aQuatonomous/Aqua-BMS-Monitor/bom.csv.xlsx

Designator | Footprint | Quantity | Value | LCSC Part # | Digikey Part # | Place | Logan Flag | Comments | Validated by Logan
3TFUSE1 | FUSE-SMD_3P-L9.5-W5.0_SFK-5030X | 1 | SCF9550-45-07 | C3667292 |  | Yes |  | Somehow | x
BC1 | 1nF_C0805 | 1 | 1nF | C94121 |  | Yes |  |  | x
BC2, C4 | 100pF_C0603 | 2 | 100pF | C160903 |  | Yes |  |  | x
BC3 | 603 | 1 | 0.47uF | C513577 |  | Yes |  |  | x
BD1, BD2, CHD1, D15, DD2, RD1, RD2 | 100V_Schottky | 7 | 100V | C698821 |  | Yes |  | Polarity -> should make sure assigned properly | x
BETTER1 | 1101A2CQEA-Switch | 1 | ~ |  | 2449-1101A2CQEA-ND | Yes | x | Throughhole - we can just order
BMSC1, C1-0, C2-0, CC2-1, CC3-2, CC4-3 | 402 | 6 | 220nF | C5159775 |  | Yes |  |  | x
BOOT0, RESET | SW_Push_YZA-009 | 2 | SW_Push | C49108621 |  | Yes |  |  | x
BQ296115DSGR1 | BQ296115DSGR | 1 | ~ | C2864839 |  | Yes |  |  | x
BR1 | 603 | 1 | 100 | C177347 |  | Yes | x | wrong value originally | Switched
C70, C71, C72, MCUC18 | 1uF_C0402 | 4 | 1 uF | C29266 |  | Yes |  | 16V, but that's okay! | x
CELLIN1 | CONN-TH_B5B-XH-A-LF-SN | 1 | 1 low 5 high | C157991 |  | DNP | x | This doesn't need to be PCBA - ungodly cheap tho
CHC1, CHC2, DC1, DC2, FC1, PCC1, PCC2, PDC1, PDC2, XC2, XCSHUN1 | 603 | 11 | 0.1uF | C14663 |  | Yes |  |  | x
CHD2, D17, DD1, DD3 | 16V_Zener | 4 | 16V | C2105 |  | Yes |  | Polarity -> should make sure assigned properly | x
CHFET1, DFET1, DFET2, DFET3, DFET4, FFET1, NMOS1 | NMOS | 7 | NMOS | C49435644 |  | Yes |  |  | x
CHR1, DR1, DR4, PCR2, R46, RR2 | 603 | 6 | 10M | C141675 |  | Yes |  |  | x
CHR2, DR3, FUSER2, PCR3, PDR3, USBR1, USBR2, XOUT1 | 5.1k_100mW_R0603 | 8 | 5.1k | C23186 |  | Yes |  |  | x
CR1, CR2, CR3, CR4, CR5 | 50_100mW_R0805 | 5 | 50 | C5355206 |  | Yes |  |  | x
D1 | D_SMF | 1 | SMF7V0A | C320558 |  | Yes | x | Found a new tvs diode - supposeely compatable with the DO-219AB package
D2 | D_SMF | 1 | SMF30A | C1973936 |  | Yes | x | Found a new tvs diode
DC3 | 47nF_C0603 | 1 | 47nF | C107093 |  | Yes |  |  | x
DCHGTP | TestPoint_Pad_D1.5mm | 1 | DCHGTP |  |  | Yes
DFETGATE3, DFETGATE4 | 603 | 2 | 10 | C109318 |  | Yes |  |  | x
DR2, PDR1 | 603 | 2 | 1k | C116692 |  | Yes |  |  | x
DR5 | 5.1k_R1210 | 1 | 1k | C185762 |  | Yes |  |  | x
DRGATE1, DRGATE2 | 51_R1206 | 2 | 51 | C702864 |  | Yes |  |  | x
FB1, FB2 | 2.2k_Ferrite_Bead_L0603 | 2 | 2.2k | C2942905 |  | Yes |  |  | x
FR1 | 603 | 1 | 20k | C22173 |  | Yes |  |  | x
FRSHUNT1 | 1m_Shunt_4W | 1 | 0.001 | C469381 |  | Yes |  |  | x
J1+A31:J31 | 3P_Pin_Header | 1 | UART Jpins | C2320 |  | DNP | x | This doesn't need to be PCBA - ungodly cheap tho
J2, J3, J4, J6 | AMASS_XT60PW-M | 4 | XT60PW-M | C98732 |  | Yes |  | great deal - keep pcba | x
J5 | HARWIN_M20-8890445 | 1 | SWD_01x04_Pin | C3324250 |  | DNP |  | This doesn't need to be pcba and is smt we should buy anyway
J7 | USB_C_DB-108PWB | 1 | USB_C_Female_USB2_Small | C5178541 |  | Yes |  | Alisa, please double check this just cause it's complex. But looks fine | x
LDR1, R47 | 603 | 2 | 10k | C98220 |  | Yes |  |  | x
LED1, LED2, LED3, LED5 | LED0805-RD | 4 | XZCM2CRK53WA-8VF | C7280946 |  | Yes |  |  | x
LEDR1, LEDR2, LEDR3, LEDR5 | 4k_R0805 | 4 | 4k | C2828855 |  | Yes |  |  | x
MCUC11, MCUC12, MCUC13, MCUC14, MCUC15, MCUC17 | 100nF_C0402 | 6 | 100 nF | C77020 |  | Yes |  |  | x
MCUC16 | 4.7uF_C0402 | 1 | 4.7 uF | C23733 |  | Yes |  |  | x
MCUC19 | 100nF_C0402 | 1 | 0.1 uF | C77020 |  | Yes |  |  | x
MCUC20, MCUC21 | 2.2uF_C0402 | 2 | 2.2 uF | C72203 |  | Yes |  |  | x
MCUDFETOFFTP | TestPoint_Pad_D1.5mm | 1 | MDfetOffTP |  |  | Yes
MCUR1, MCUR3, TSR1 | 10k_62.5mW_R0402 | 3 | 10k | C60490 |  | Yes |  |  | x
MCUR2, MCUR4 | 100k_R0402 | 2 | 100k | C60491 |  | Yes |  |  | x
MCUR5, MCUR6 | 4.7k_R0402 | 2 | 4.7k | C25940 |  | Yes |  |  | x
MCUTVS1, MCUTVS2, MCUTVS3, MCUTVS4 | 5V_TVS_SOD-323_L1.8-W1.3-LS2.5-BI | 4 | PTVSUC3D5VB | C918847 |  | Yes |  |  | x
OSCC1, OSCC2 | 16pF_C0402 | 2 | 16 pF | C77590 |  | Yes |  |  | x
PACKR1 | 10k_R1206 | 1 | 10k | C1489 |  | Yes |  |  | x
PCFET1, PDFET1 | PMOS | 2 | PMOS | C10884 |  | Yes |  | not 100% sure, but pre sure this is right | x
PCR1, XRC1, XRC2, XRC3, XRC4 | 1k_R1206 | 5 | 1k | C1469 |  | Yes |  |  | x
PDR2 | 603 | 1 | 10M | C141675 |  | Yes |  |  | x
Q6 | NPN_BJT | 1 | NPN | C53064208 |  | Yes |  | This is fine, but supposedly the same footprint as the pmos, but they look different | x
RC1, RC3, RC4 | 1uF_C0402 | 3 | 1uF | C29266 |  | Yes |  |  | x
RC2 | 402 | 1 | 22nF | C107026 |  | Yes |  |  | x
RR1 | 300_250mW_R1206 | 1 | 300 | C17887 |  | Yes |  |  | x
RSHUNT1, RSHUNT2, RSHUNT3, RSHUNT4 | 200_R1210 | 4 | 200 | C102427 |  | Yes |  | was - C26060 which is wrong | x
S1 | MHPS2285N | 1 | MHPS2285N |  | MHPS2285N-ND | DNP |  | Throughpin all good to ignore from JLC
S2, S3, S4, S5, S6 | SW_EG1218 | 5 | EG1218 |  | EG1903-ND | DNP |  | Not an amazing deal could do non-JLC
SC1, SC2, XC5 | 402 | 3 | 0.1 uF | C77020 |  | Yes |  |  | x
SC3 | 402 | 1 | 100 nF | C77020 |  | Yes |  | Blank - Added by logan | x
SCLTP | TestPoint_Pad_D1.5mm | 1 | MCUSCLTP |  |  | Yes
SDATP | TestPoint_Pad_D1.5mm | 1 | MCUSDATP |  |  | Yes
SRINN1, SRINP1, XRC5, XSHUN1 | 402 | 4 | 100 | C4350330 |  | Yes |  | Blank -Added by logan | x
TH1, TH3 | PTC_Thermistor_TMP6131LPGM | 2 | Thermistor_US |  |  | DNP |  | Through pin and we don't necessairly want them right in the board - I would not have them assembled on board
TH2 | PTC_Thermistor_TMP6131LPGM | 1 | Simitac 103-AT |  |  | DNP |  | Through pin and we don't necessairly want them right in the board - I would not have them assembled on board
TP1 | TestPoint_Pad_D1.5mm | 1 | BATplusTP
TP10 | TestPoint_Pad_D1.0mm | 1 | BatTP
TP11 | TestPoint_Pad_D1.0mm | 1 | CPTP
TP13 | TestPoint_Pad_D1.0mm | 1 | ReRHTP
TP14 | TestPoint_Pad_D1.0mm | 1 | ReColTP
TP16 | TestPoint_Pad_D1.0mm | 1 | Ccell0TP
TP17 | TestPoint_Pad_D1.5mm | 1 | TS2TP
TP18 | TestPoint_Pad_D1.0mm | 1 | HDQTP
TP20 | TestPoint_Pad_D1.5mm | 1 | CpackTP
TP21 | TestPoint_Pad_D1.5mm | 1 | DpackTP
TP22 | TestPoint_Pad_D1.0mm | 1 | ChGpackTP
TP23 | TestPoint_Pad_D1.5mm | 1 | RXTP
TP26 | TestPoint_Pad_D1.5mm | 1 | CDTP
TP27 | TestPoint_Pad_D1.0mm | 1 | FuseGate
TP28 | TestPoint_Pad_D1.5mm | 1 | Cell0TP
TP29 | TestPoint_Pad_D1.5mm | 1 | Cell1TP
TP30 | TestPoint_Pad_D1.5mm | 1 | Cell2TP
TP31 | TestPoint_Pad_D1.5mm | 1 | Cell3TP
TP32 | TestPoint_Pad_D1.5mm | 1 | Cell4TP
TP33 | TestPoint_Pad_D1.0mm | 1 | Ccell1TP
TP34 | TestPoint_Pad_D1.0mm | 1 | Ccell2TP
TP35 | TestPoint_Pad_D1.0mm | 1 | Ccell3TP
TP36 | TestPoint_Pad_D1.0mm | 1 | Ccell4TP
TP37 | TestPoint_Pad_D1.0mm | 1 | Xpro0VDDTP
TP38 | TestPoint_Pad_D1.0mm | 1 | Xcel4TP
TP39 | TestPoint_Pad_D1.0mm | 1 | Xcel3TP
TP40 | TestPoint_Pad_D1.0mm | 1 | Xcel1TP
TP41 | TestPoint_Pad_D1.0mm | 1 | Xcel2TP
TP42 | TestPoint_Pad_D1.5mm | 1 | XregTP
TP43 | TestPoint_Pad_D1.0mm | 1 | XoutTP
TP44 | TestPoint_Pad_D1.0mm | 1 | BregTP
TP46 | TestPoint_Pad_D1.0mm | 1 | Reg1TP
TP48 | TestPoint_Pad_D1.0mm | 1 | PCHGTP
TP49 | TestPoint_Pad_D1.0mm | 1 | PDSGTP
TP5 | TestPoint_Pad_D1.5mm | 1 | TXTP
TP50 | TestPoint_Pad_D1.5mm | 1 | PreRLDTP
TP51 | TestPoint_Pad_D1.0mm | 1 | LDTP
TP52 | TestPoint_Pad_D1.5mm | 1 | PackTP
TP53 | TestPoint_Pad_D1.0mm | 1 | CmpGTP
TP54 | TestPoint_Pad_D1.0mm | 1 | DDriveTP
TP55 | TestPoint_Pad_D1.0mm | 1 | DSGTP
TP57 | TestPoint_Pad_D1.0mm | 1 | IDGTP
TP58 | TestPoint_Pad_D1.0mm | 1 | IDVSSTP
TP6 | TestPoint_Pad_D1.0mm | 1 | SRNTP
TP60 | TestPoint_Pad_D1.5mm | 1 | V_REGUSBTP
TP62 | TestPoint_Pad_D1.5mm | 1 | VCAP2TP
TP63 | TestPoint_Pad_D1.5mm | 1 | ALERTTP
TP64 | TestPoint_Pad_D1.5mm | 1 | BOOT0TP
TP65 | TestPoint_Pad_D1.5mm | 1 | NRSTTP
TP66 | TestPoint_Pad_D1.5mm | 1 | MCfetOffTP
TP67 | TestPoint_Pad_D1.5mm | 1 | CfetOffTP
TP69 | TestPoint_Pad_D1.5mm | 1 | DfetOffTP
TP7 | TestPoint_Pad_1.5x1.5mm | 1 | VSSTP
TP71 | TestPoint_Pad_D1.5mm | 1 | DDSGTP
TP72 | TestPoint_Pad_D1.5mm | 1 | RST_SHUTTP
TP8 | TestPoint_Pad_D1.0mm | 1 | SRPTP
TP9 | TestPoint_Pad_D1.5mm | 1 | PWRplusTP
TS1TP | TestPoint_Pad_D1.0mm | 1 | TS1TP
TS3TP | TestPoint_Pad_D1.0mm | 1 | TS3TP
TSC1, TSC2, TSC3 | 470pF_C0402 | 3 | 470 pF | C1537 |  | Yes |  |  | x
TSRST1 | SW_Push_YZA-009 | 1 | Button | C49108621 |  | Yes |  |  | x
U1 | BQ7695202PFBR | 1 | BQ7695202 | C3038665 |  | Yes |  | THANK GOD THEY HAVE THIS | x
U2 | LQFP-64_10x10mm_P0.5mm | 1 | STM32F205RETx | C66278 |  | Yes |  |  | x
U4, U5, U6 | LM66100DCKR | 3 | LM66100DCKR | C2869734 |  | Yes |  |  | x
U7 | DFN-6-1EP_3x2mm_P0.5mm_EP1.65x1.35mm | 1 | LTC4359-DCB | C7454463 | 505-LTC4359CDCB#TRPBFCT-ND | DNP | x | I think this is the right one, pls double check505-LTC4359CDCB#TRPBFCT-ND | x
U9 | SOT-223-3_TabPin2 | 1 | AMS1117-3.3 | C6186 |  | Yes |  |  | x
USBC1, USBC2 | 10uF_C0603 | 2 | 10 uF | C96446 |  | Yes |  |  | x
USBR3 | 1.5k_100mW_R0603 | 1 | 1.5k | C22843 |  | Yes |  |  | x
VCAP1TP | TestPoint_Pad_D1.5mm | 1 | Vcap1TP |  |  | Yes
V_SWDTP | TestPoint_Pad_D1.5mm | 1 | VSWDTP |  |  | Yes
X1 | 18pF_Oscillator_CRYSTAL-SMD_4P | 1 | X322516MRB4SI | C70562 |  | Yes |  |  | x
XC1, XC3, XC4 | 402 | 3 | 0.1uF | C77020 |  | Yes |  |  | x
XCREG1 | 0.47 uF_C1210 | 1 | 0.47 uF | C309505 |  | Yes |  |  | x
XRREG1 | 5_1W_R2512 | 1 | 5 | C5123609 |  | Yes |  |  | x
