aQuatonomous/Aqua-BMS-Monitor/ProjectLib/3dmodels/EG1218.step

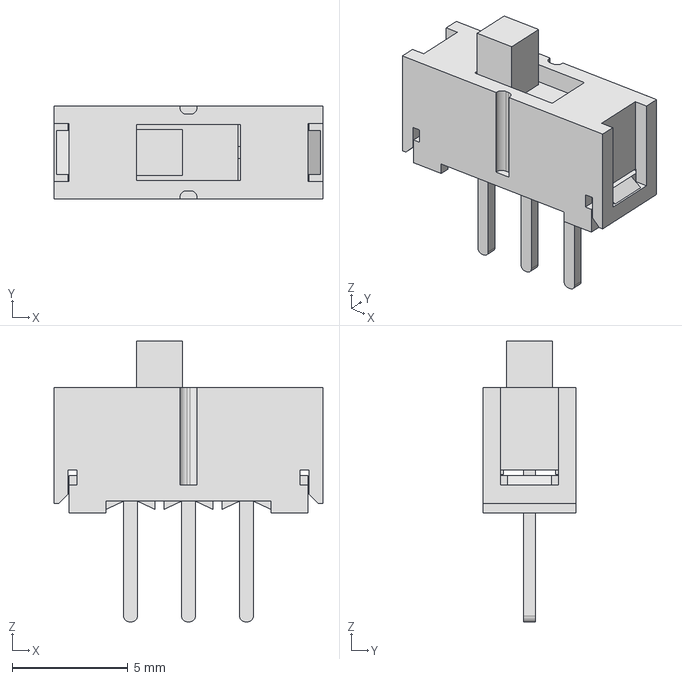
[picture p1: CAD file, 2026-08-05]
ProjectLib/3dmodels/EG1218.step
11.6 x 4.00 x 12.1 mm
