aQuatonomous/Aqua-BMS-Monitor/ProjectLib/3dmodels/XT60PW-M.step

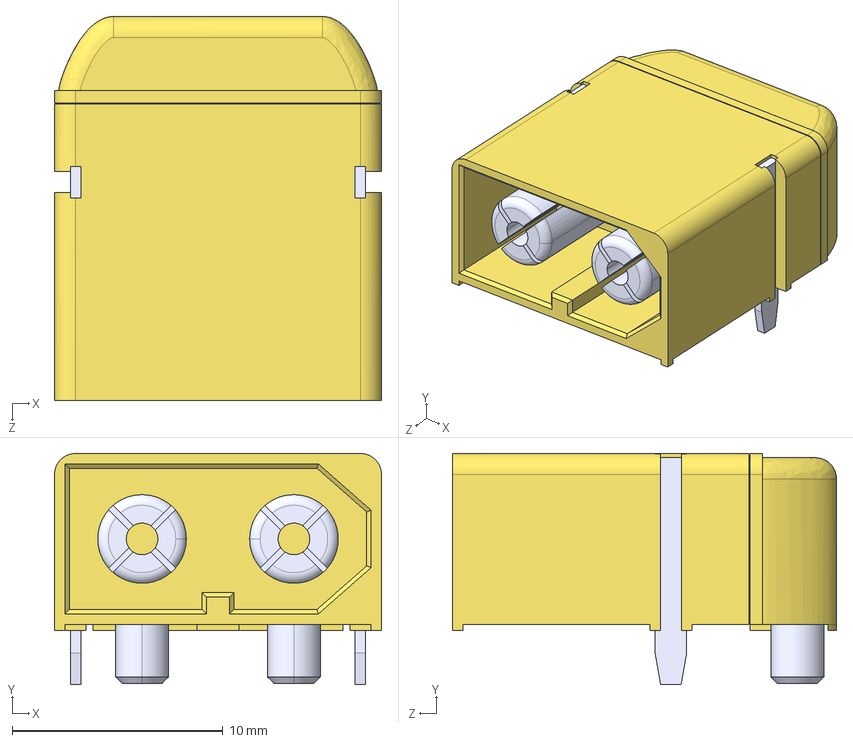
[picture p2: CAD file, 2026-07-28]
ProjectLib/3dmodels/XT60PW-M.step
15.5 x 10.9 x 18.2 mm
