aQuatonomous/Aqua-BMS-Monitor/ProjectLib/3dmodels/BQ76952PFBR.step

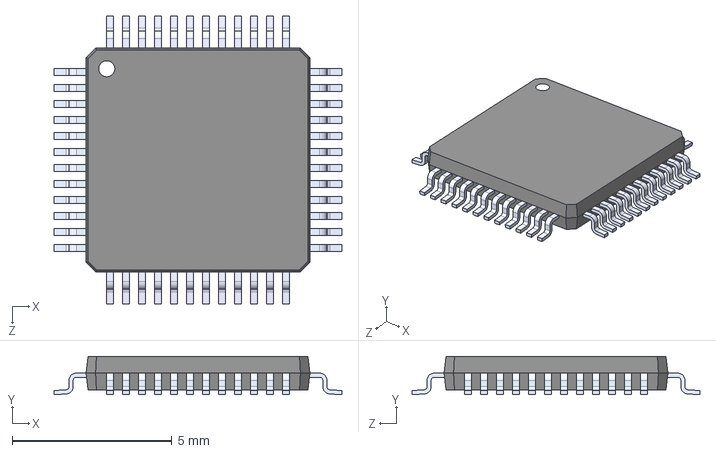
[picture p3: CAD file, 2026-03-28]
ProjectLib/3dmodels/BQ76952PFBR.step
9.00 x 1.20 x 9.00 mm
