aQuatonomous/Aqua-BMS-Monitor/Ideal diode controller.asc

C1: Cap; 47n
C2: Cap; 50n
C3: Cap; 47n
D1: zener; KDZLV75
D2: TVSdiode; SMBJ24CA
D3: zener; KDZLV75
D4: TVSdiode; SMBJ24CA
Ielectronics: current; 4.5
L1: Ind; 10n
M1: nmos; BSC010NE2LS
M2: nmos; IPT004N03L
M3: nmos; BSC010NE2LS
R1: Res; 1k
R2: Res; 16
R3: Res; 1k
R4: Res; 1k
R5: Res; 50
R6: Res; 10k
R7: Res; 1k
Rsrc1: Res; 10m
Rsrc2: Res; 10m
U1: LTC4359
U2: LTC4359
V1: Voltage; 0
V2: Voltage; 16
Vhigh: Voltage; Vhigh
VloadGate: Voltage; PULSE(0 25 0.5m 10u 10u 12.5m)
Named nets: 0, Vout, Vgate, Vin, Vss, Vload, Vout2, Vgate2, Vin2, Vss2, Vread2, Vread1
No TVS higher than 33 in spice avail right now, chose 75 zener
.tran 15m
.dc Vhigh 15.8 16.20 0.025
