aQuatonomous/Aqua-BMS-Monitor/Aqua BMS Monitor(MAIN).kicad_pcb

## KiCad design Aqua BMS Monitor(MAIN).kicad_pcb (2026-09-09)

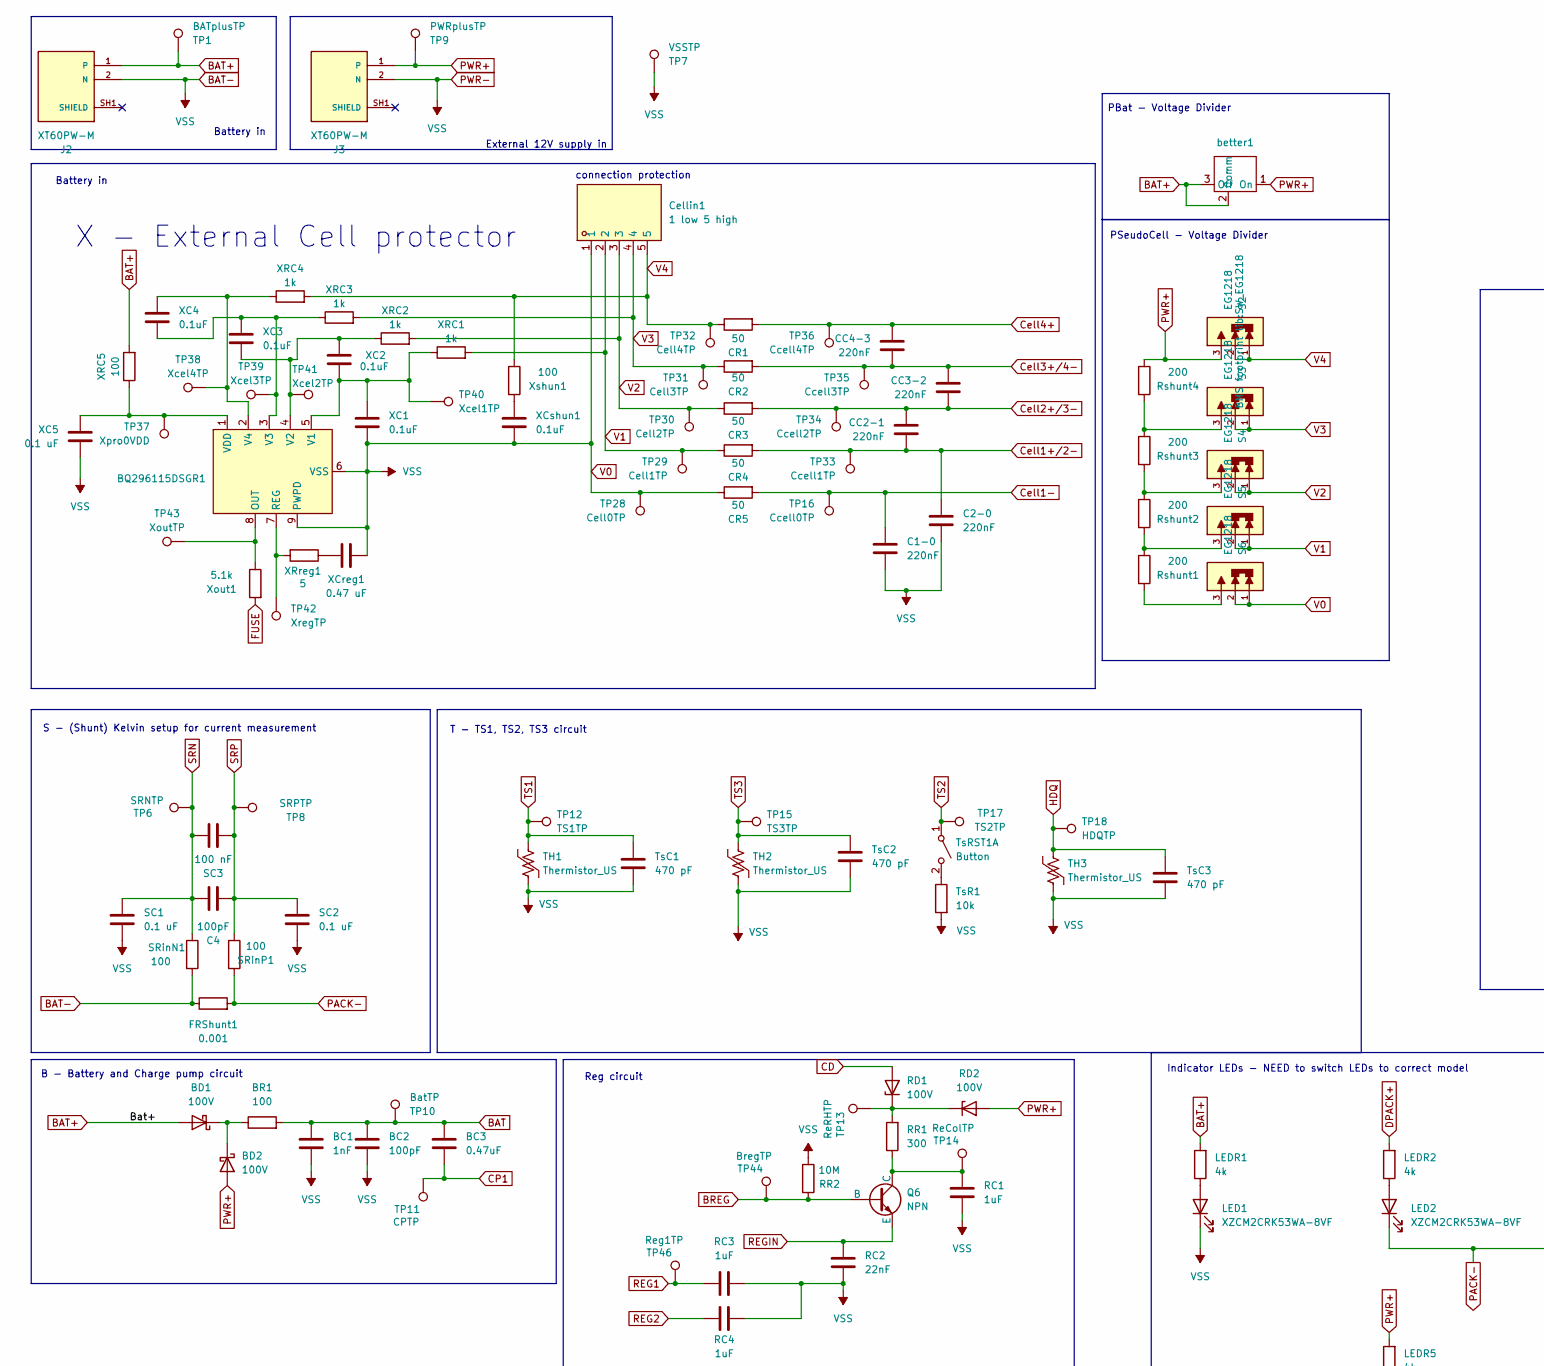
[picture p4: schematic Aqua BMS Monitor(MAIN).kicad_sch, part in row 1, column 1]

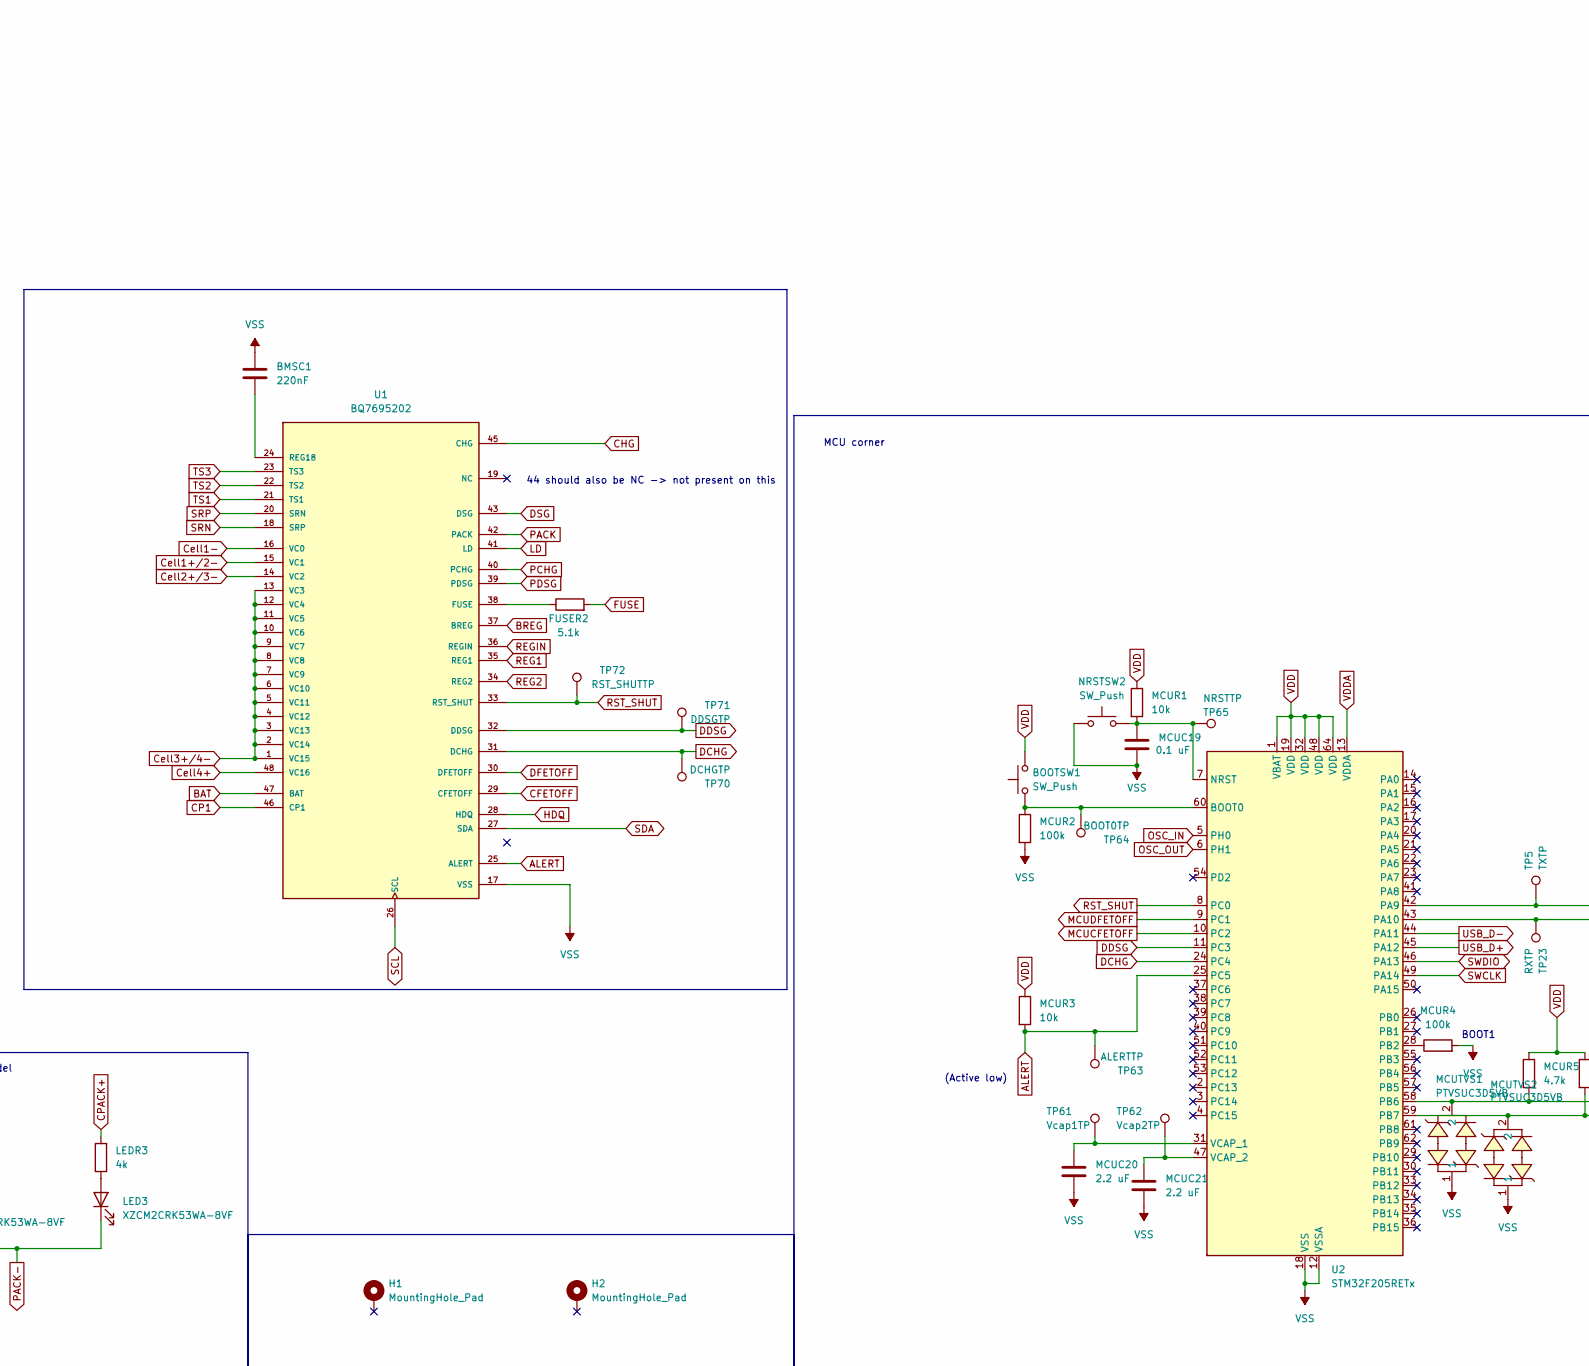
[picture p5: schematic Aqua BMS Monitor(MAIN).kicad_sch, part in row 1, column 2]

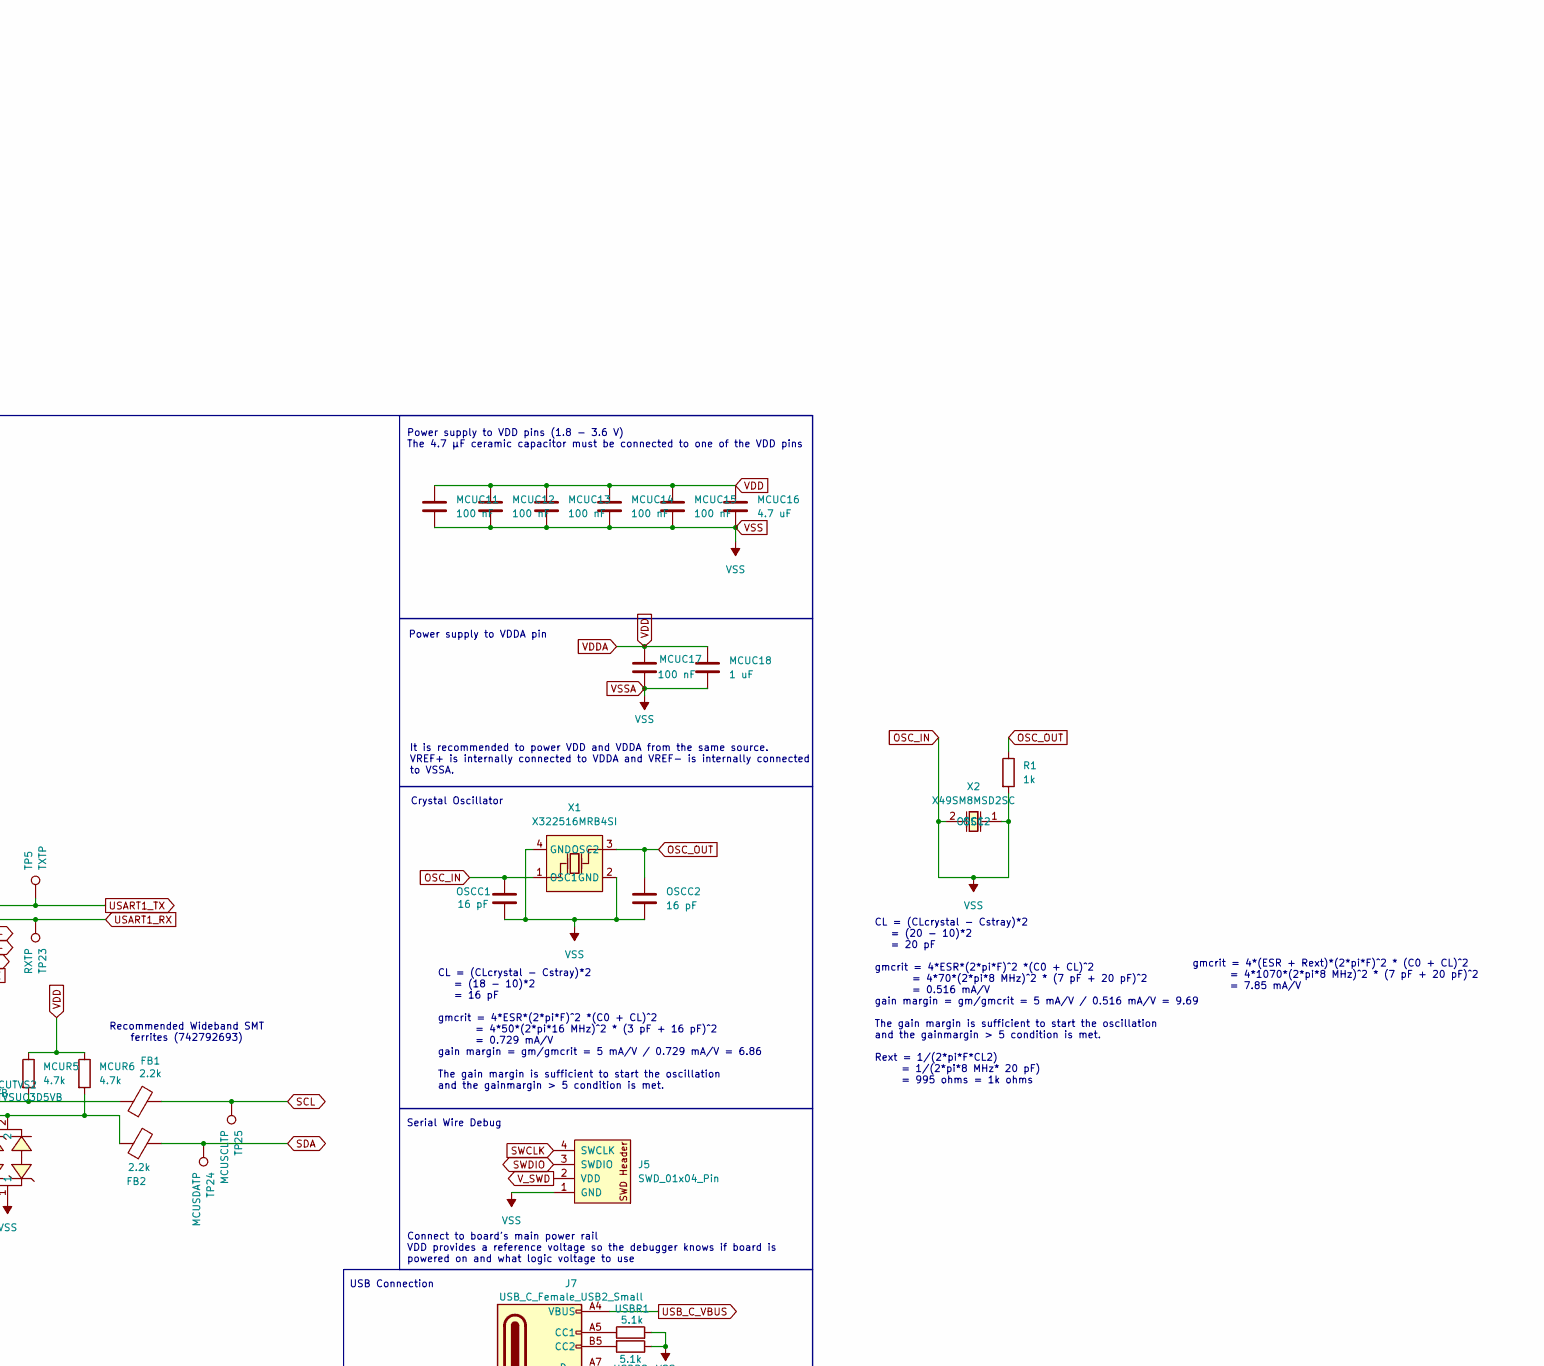
[picture p6: schematic Aqua BMS Monitor(MAIN).kicad_sch, part in row 1, column 3]

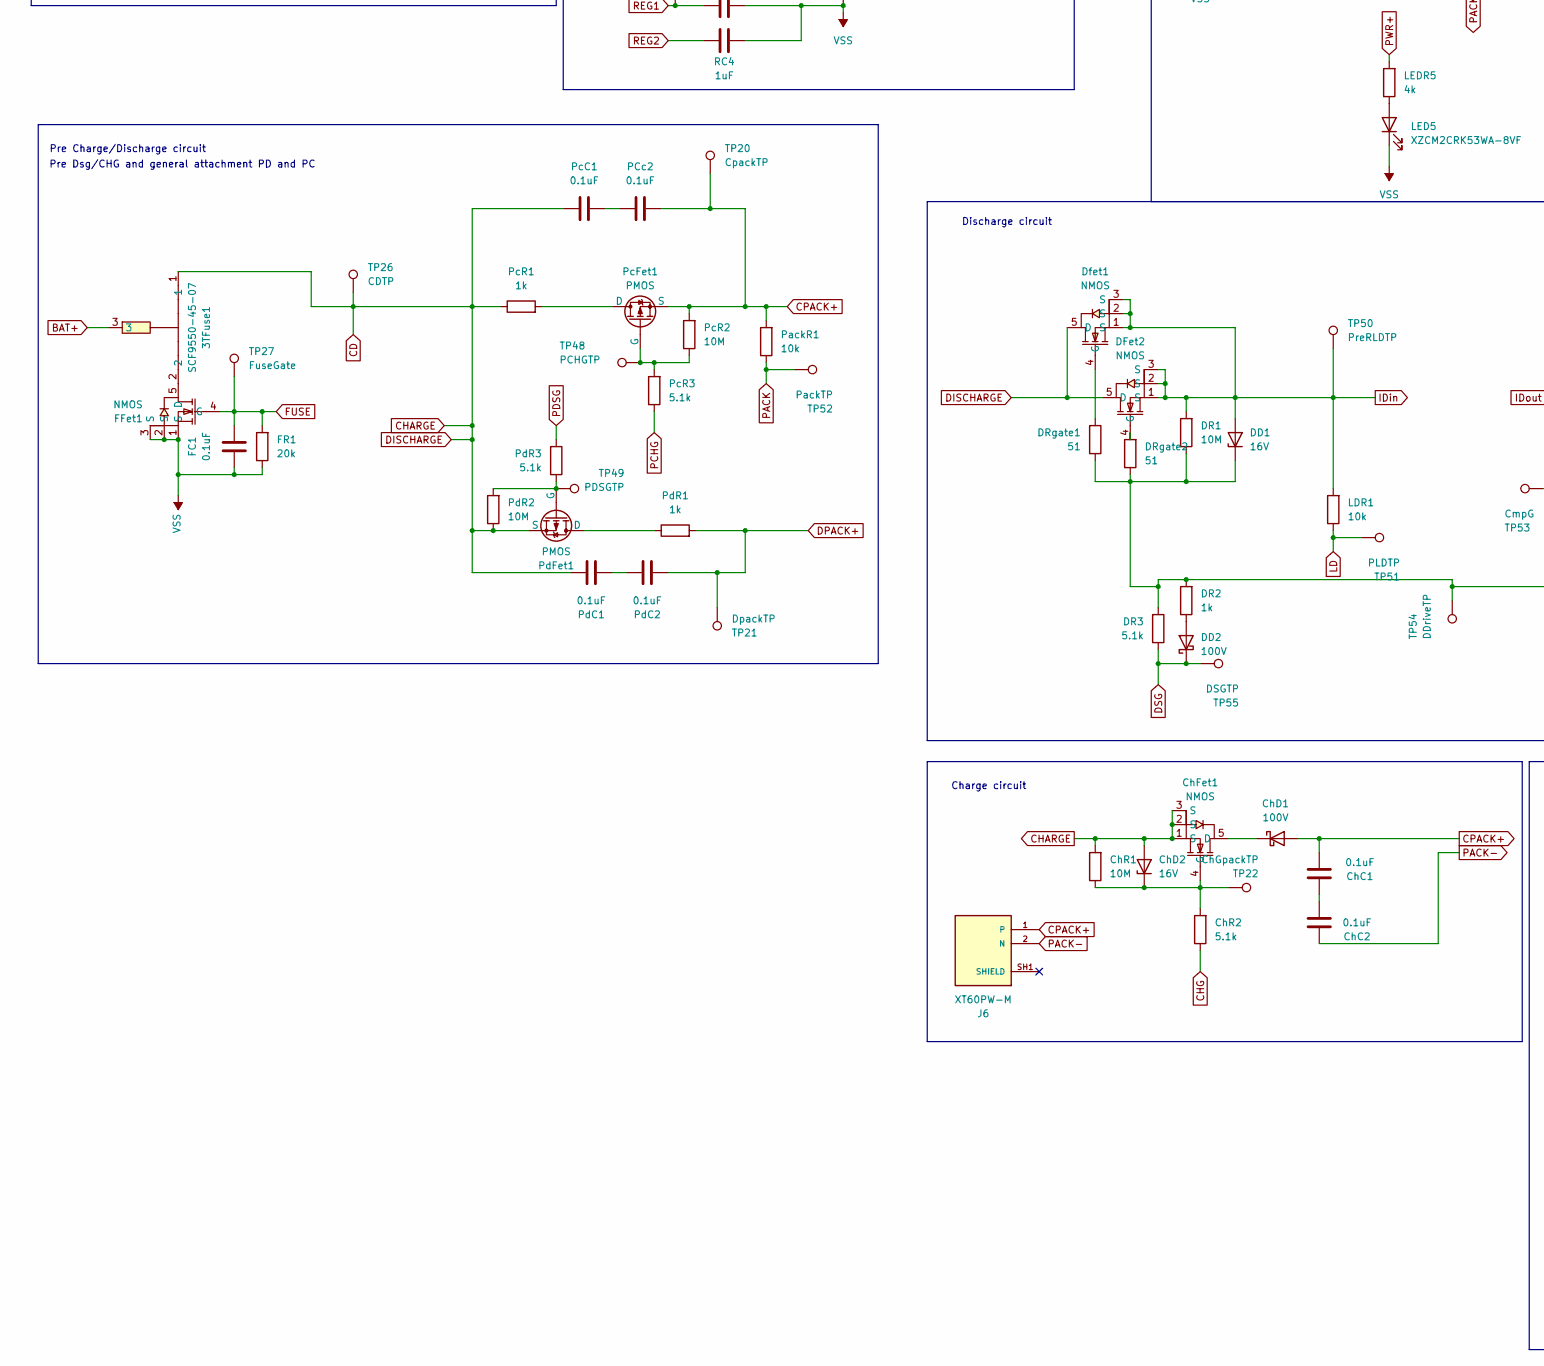
[picture p7: schematic Aqua BMS Monitor(MAIN).kicad_sch, part in row 2, column 1]

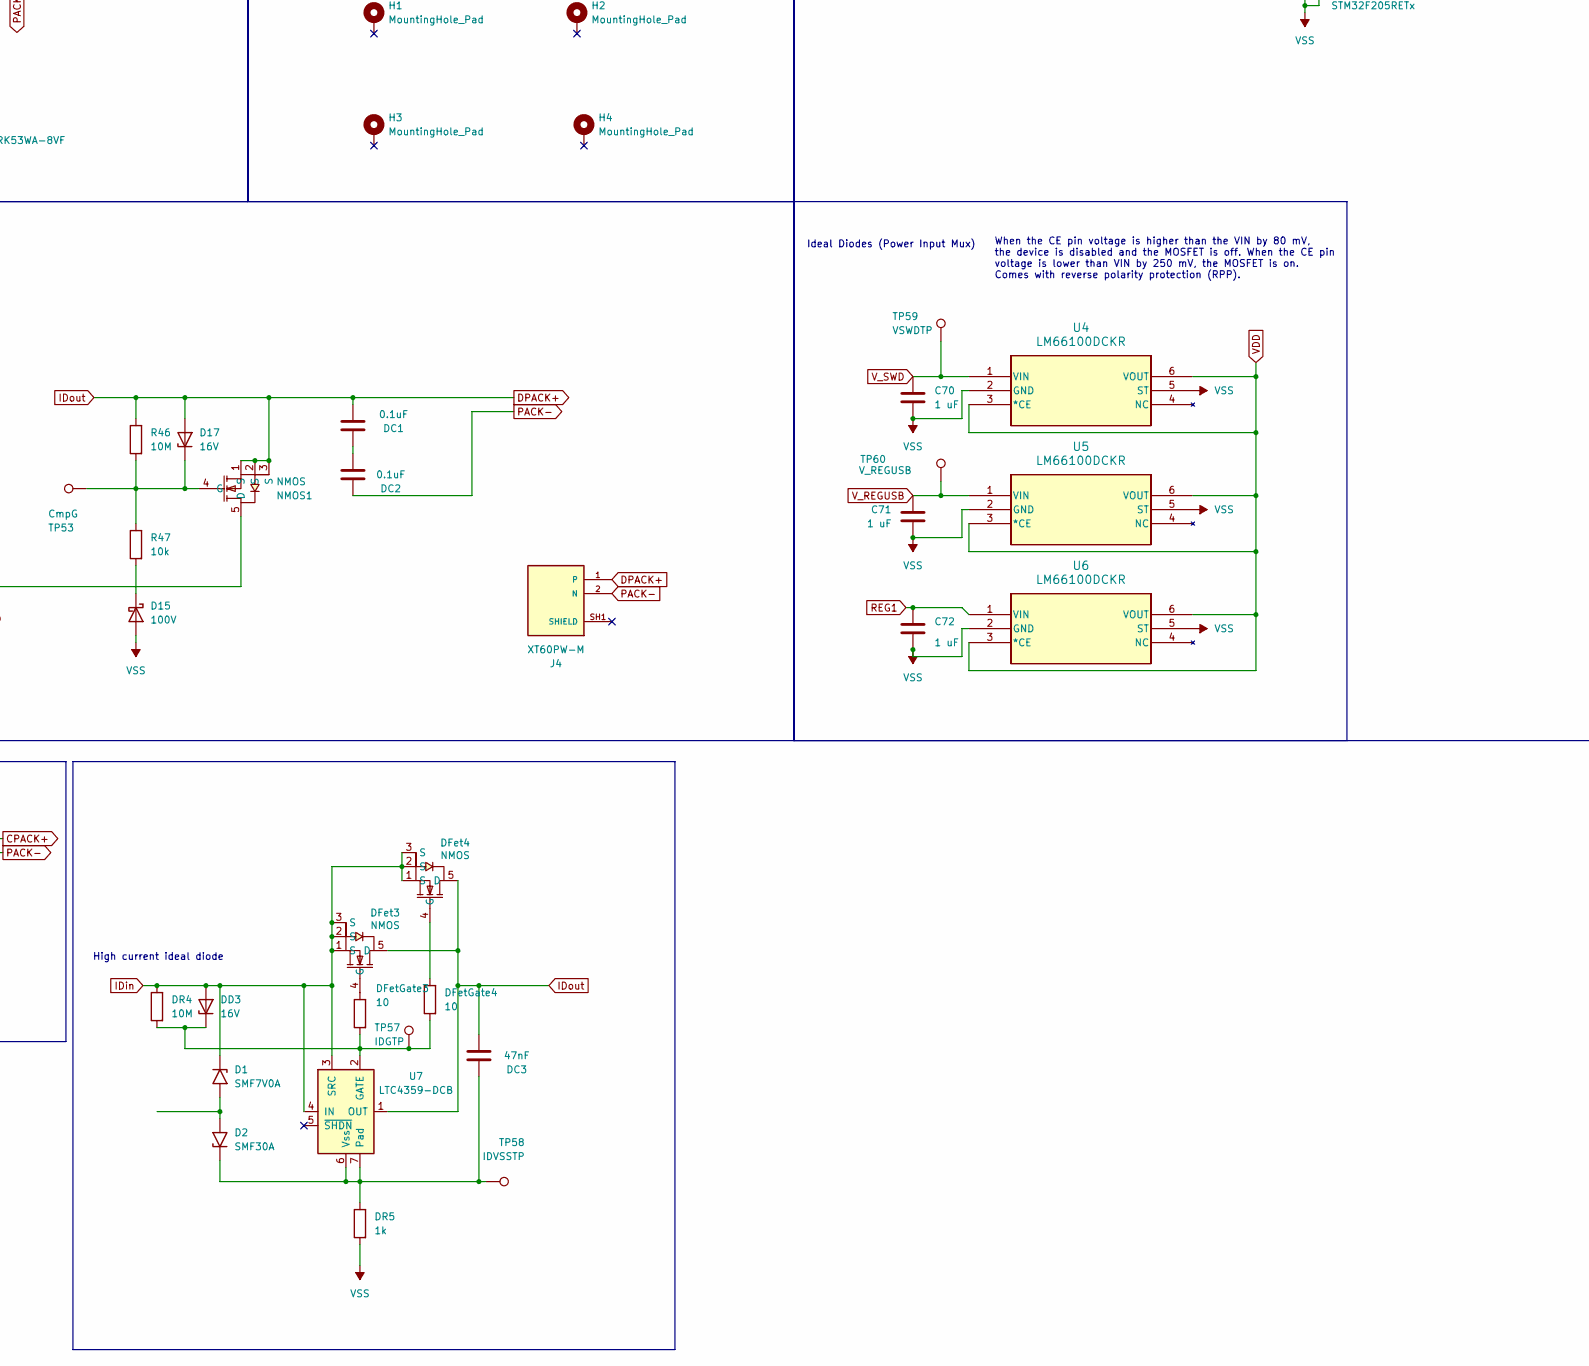
[picture p8: schematic Aqua BMS Monitor(MAIN).kicad_sch, part in row 2, column 2]

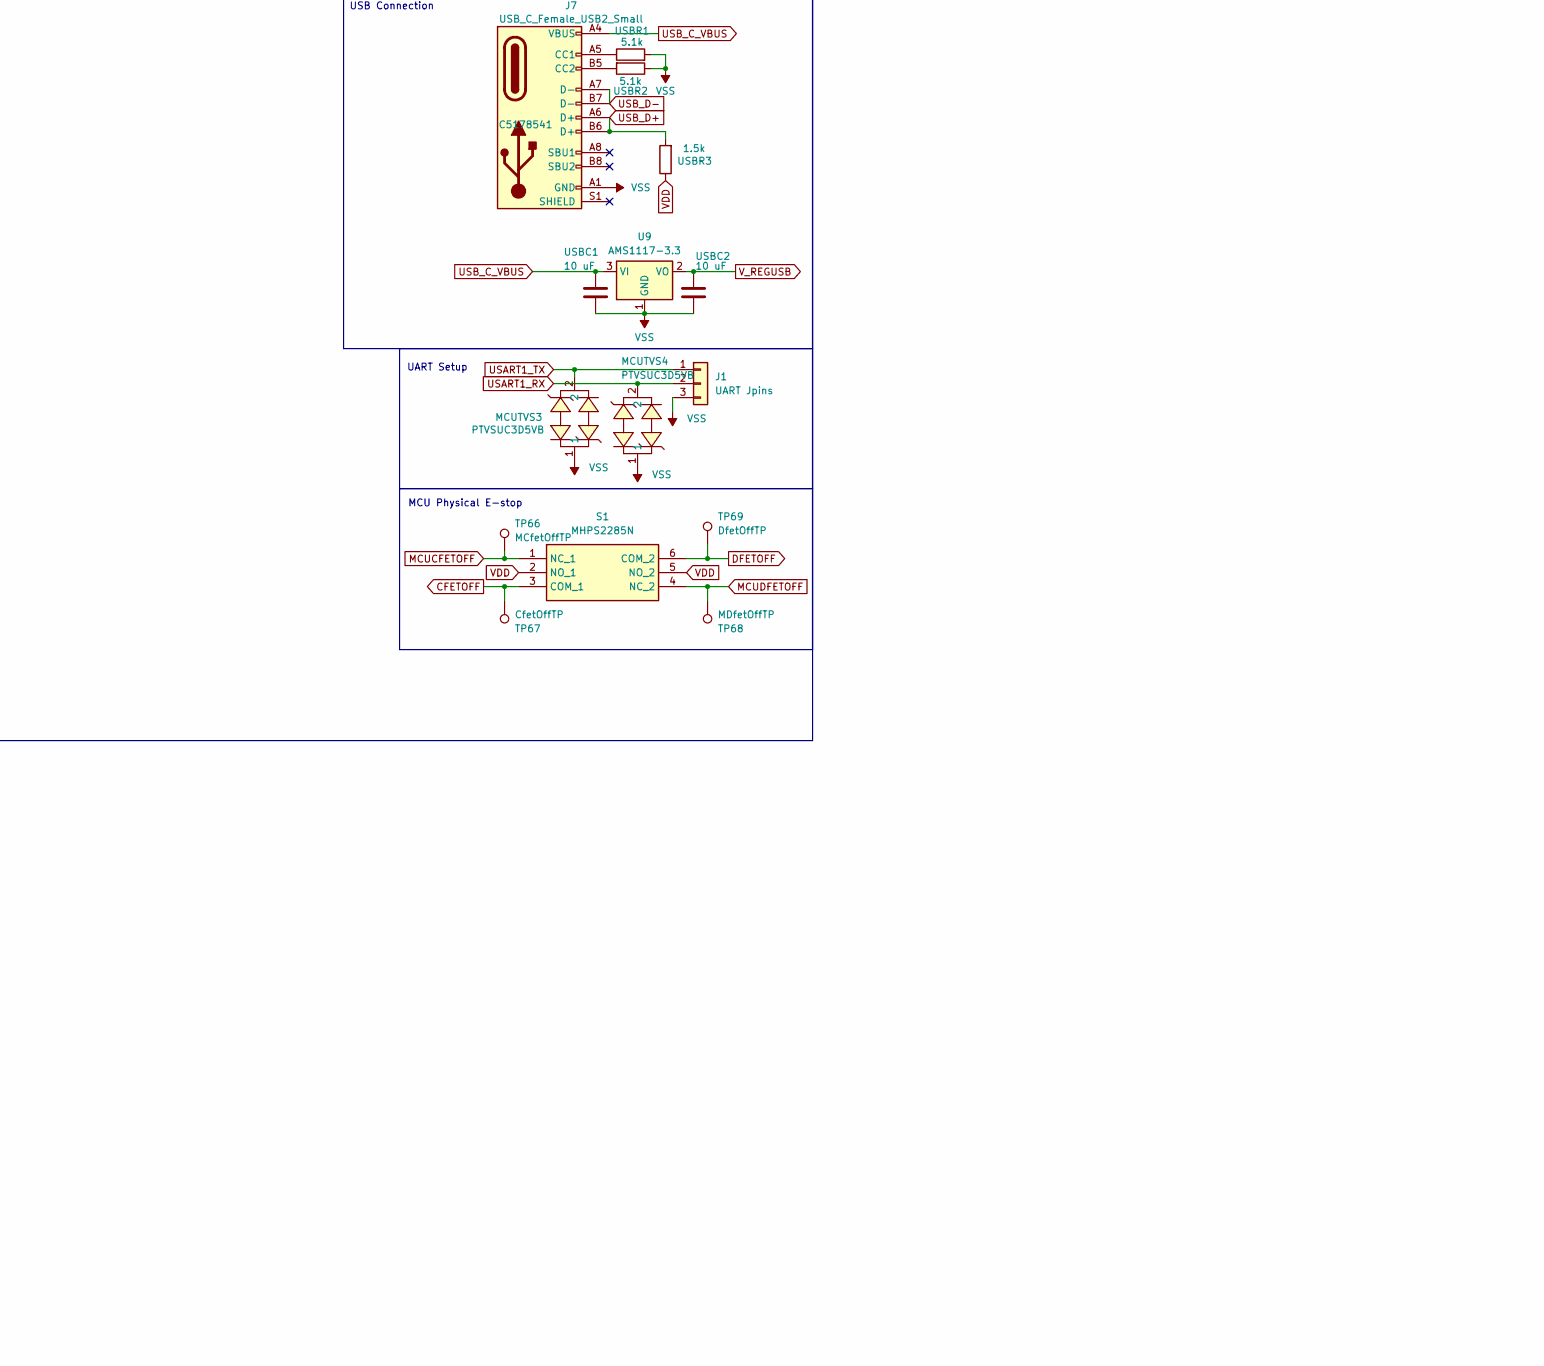
[picture p9: schematic Aqua BMS Monitor(MAIN).kicad_sch, part in row 2, column 3]

Parts:
3TFuse1: SCF9550-45-07; FUSE-SMD_3P-L9.5-W5.0_SFK-5030X; MPN SCF9550-45-07; LCSC Part C3667292
BC1: 1nF; 1nF_C0805
BC2: 100pF; 100pF_C0603
BC3: 0.47uF; C_0603_1608Metric
BD1, BD2: 100V; 100V_Schottky
BMSC1: 220nF; C_0402_1005Metric
BOOTSW1: SW_Push; SW_Push_YZA-009
BQ296115DSGR1: BQ296115DSGR
BR1: 100; R_0603_1608Metric
C1-0, C2-0: 220nF; C_0402_1005Metric
C4: 100pF; 100pF_C0603
C70, C71, C72: 1 uF; 1uF_C0402
CC2-1, CC3-2, CC4-3: 220nF; C_0402_1005Metric
CR1, CR2, CR3, CR4, CR5: 50; 50_100mW_R0805
Cellin1: 1 low 5 high; CONN-TH_B5B-XH-A-LF-SN; MPN B5B-XH-A(LF)(SN); LCSC Part C157991
ChC1, ChC2: 0.1uF; C_0603_1608Metric
ChD1: 100V; 100V_Schottky
ChD2: 16V; 16V_Zener
ChFet1: NMOS; MPN H7534N; LCSC Part C49435644
ChR1: 10M; R_0603_1608Metric
ChR2: 5.1k; 5.1k_100mW_R0603
D1: SMF7V0A; D_SMF
D2: SMF30A; D_SMF
D15: 100V; 100V_Schottky
D17: 16V; 16V_Zener
DC1, DC2: 0.1uF; C_0603_1608Metric
DC3: 47nF; 47nF_C0603
DD1, DD3: 16V; 16V_Zener
DD2: 100V; 100V_Schottky
DFet2, DFet3, DFet4: NMOS; MPN H7534N; LCSC Part C49435644
DFetGate3, DFetGate4: 10; R_0603_1608Metric
DR1, DR4: 10M; R_0603_1608Metric
DR2: 1k; R_0603_1608Metric
DR3: 5.1k; 5.1k_100mW_R0603
DR5: 1k; 5.1k_R1210
DRgate1, DRgate2: 51; 51_R1206
Dfet1: NMOS; MPN H7534N; LCSC Part C49435644
FB1, FB2: 2.2k; 2.2k_Ferrite_Bead_L0603
FC1: 0.1uF; C_0603_1608Metric
FFet1: NMOS; MPN H7534N; LCSC Part C49435644
FR1: 20k; R_0603_1608Metric
FRShunt1: 0.001; 1m_Shunt_4W
FUSER2: 5.1k; 5.1k_100mW_R0603
H1, H2, H3, H4: MountingHole_Pad; MountingHole_3.2mm_M3_Pad_TopBottom
J1: UART Jpins; 3P_Pin_Header
J2, J3, J4, J6: XT60PW-M; AMASS_XT60PW-M; PARTREV 1.2
J5: SWD_01x04_Pin; HARWIN_M20-8890445; Digikey 952-3233-ND
J7: USB_C_Female_USB2_Small; USB_C_DB-108PWB; LCSC C5178541
LDR1: 10k; R_0603_1608Metric
LED1, LED2, LED3, LED5: XZCM2CRK53WA-8VF; LED0805-RD
LEDR1, LEDR2, LEDR3, LEDR5: 4k; 4k_R0805
MCUC11, MCUC12, MCUC13, MCUC14, MCUC15, MCUC17: 100 nF; 100nF_C0402
MCUC16: 4.7 uF; 4.7uF_C0402
MCUC18: 1 uF; 1uF_C0402
MCUC19: 0.1 uF; 100nF_C0402
MCUC20, MCUC21: 2.2 uF; 2.2uF_C0402
MCUR1, MCUR3: 10k; 10k_62.5mW_R0402
MCUR2, MCUR4: 100k; 100k_R0402
MCUR5, MCUR6: 4.7k; 4.7k_R0402
MCUTVS1, MCUTVS2, MCUTVS3, MCUTVS4: PTVSUC3D5VB; 5V_TVS_SOD-323_L1.8-W1.3-LS2.5-BI; MPN PTVSUC3D5VB; LCSC Part C918847
NMOS1: NMOS; MPN H7534N; LCSC Part C49435644
NRSTSW2: SW_Push; SW_Push_YZA-009
OSCC1, OSCC2: 16 pF; 16pF_C0402
PCc2: 0.1uF; C_0603_1608Metric
PackR1: 10k; 10k_R1206
PcC1: 0.1uF; C_0603_1608Metric
PcFet1: PMOS
PcR1: 1k; 1k_R1206
PcR2: 10M; R_0603_1608Metric
PcR3: 5.1k; 5.1k_100mW_R0603
PdC1, PdC2: 0.1uF; C_0603_1608Metric
PdFet1: PMOS
PdR1: 1k; R_0603_1608Metric
PdR2: 10M; R_0603_1608Metric
PdR3: 5.1k; 5.1k_100mW_R0603
Q6: NPN; NPN_BJT
R1: 1k
R46: 10M; R_0603_1608Metric
R47: 10k; R_0603_1608Metric
RC1, RC3, RC4: 1uF; 1uF_C0402
RC2: 22nF; C_0402_1005Metric
RD1, RD2: 100V; 100V_Schottky
RR1: 300; 300_250mW_R1206
RR2: 10M; R_0603_1608Metric
Rshunt1, Rshunt2, Rshunt3, Rshunt4: 200; 200_R1210
S1: MHPS2285N; Mouser Part Number 642-MHPS2285N
S2, S3, S4, S5, S6: EG1218; SW_EG1218
SC1, SC2: 0.1 uF; C_0402_1005Metric
SC3: 100 nF; C_0402_1005Metric
SRinN1: 100; R_0402_1005Metric
SRinP1: 100; R_0402_1005Metric
TH1, TH2, TH3: Thermistor_US; PTC_Thermistor_TMP6131LPGM
TP1: BATplusTP; TestPoint_Pad_D1.5mm
TP5: TXTP; TestPoint_Pad_D1.5mm
TP6: SRNTP; TestPoint_Pad_D1.0mm
TP7: VSSTP; TestPoint_Pad_1.5x1.5mm
TP8: SRPTP; TestPoint_Pad_D1.0mm
TP9: PWRplusTP; TestPoint_Pad_D1.5mm
TP10: BatTP; TestPoint_Pad_D1.0mm
TP11: CPTP; TestPoint_Pad_D1.0mm
TP12: TS1TP; TestPoint_Pad_D1.0mm
TP13: ReRHTP; TestPoint_Pad_D1.0mm
TP14: ReColTP; TestPoint_Pad_D1.0mm
TP15: TS3TP; TestPoint_Pad_D1.0mm
TP16: Ccell0TP; TestPoint_Pad_D1.0mm
TP17: TS2TP; TestPoint_Pad_D1.5mm
TP18: HDQTP; TestPoint_Pad_D1.0mm
TP20: CpackTP; TestPoint_Pad_D1.5mm
TP21: DpackTP; TestPoint_Pad_D1.5mm
TP22: ChGpackTP; TestPoint_Pad_D1.0mm
TP23: RXTP; TestPoint_Pad_D1.5mm
TP24: MCUSDATP; TestPoint_Pad_D1.5mm
TP25: MCUSCLTP; TestPoint_Pad_D1.5mm
TP26: CDTP; TestPoint_Pad_D1.5mm
TP27: FuseGate; TestPoint_Pad_D1.0mm
TP28: Cell0TP; TestPoint_Pad_D1.5mm
TP29: Cell1TP; TestPoint_Pad_D1.5mm
TP30: Cell2TP; TestPoint_Pad_D1.5mm
TP31: Cell3TP; TestPoint_Pad_D1.5mm
TP32: Cell4TP; TestPoint_Pad_D1.5mm
TP33: Ccell1TP; TestPoint_Pad_D1.0mm
TP34: Ccell2TP; TestPoint_Pad_D1.0mm
TP35: Ccell3TP; TestPoint_Pad_D1.0mm
TP36: Ccell4TP; TestPoint_Pad_D1.0mm
TP37: Xpro0VDD; TestPoint_Pad_D1.0mm
TP38: Xcel4TP; TestPoint_Pad_D1.0mm
TP39: Xcel3TP; TestPoint_Pad_D1.0mm
TP40: Xcel1TP; TestPoint_Pad_D1.0mm
TP41: Xcel2TP; TestPoint_Pad_D1.0mm
TP42: XregTP; TestPoint_Pad_D1.5mm
TP43: XoutTP; TestPoint_Pad_D1.0mm
TP44: BregTP; TestPoint_Pad_D1.0mm
TP46: Reg1TP; TestPoint_Pad_D1.0mm
TP48: PCHGTP; TestPoint_Pad_D1.0mm
TP49: PDSGTP; TestPoint_Pad_D1.0mm
TP50: PreRLDTP; TestPoint_Pad_D1.5mm
TP51: PLDTP; TestPoint_Pad_D1.0mm
TP52: PackTP; TestPoint_Pad_D1.5mm
TP53: CmpG; TestPoint_Pad_D1.0mm
TP54: DDriveTP; TestPoint_Pad_D1.0mm
TP55: DSGTP; TestPoint_Pad_D1.0mm
TP57: IDGTP; TestPoint_Pad_D1.0mm
TP58: IDVSSTP; TestPoint_Pad_D1.0mm
TP59: VSWDTP; TestPoint_Pad_D1.5mm
TP60: V_REGUSB; TestPoint_Pad_D1.5mm
TP61: Vcap1TP; TestPoint_Pad_D1.5mm
TP62: Vcap2TP; TestPoint_Pad_D1.5mm
TP63: ALERTTP; TestPoint_Pad_D1.5mm
TP64: BOOT0TP; TestPoint_Pad_D1.5mm
TP65: NRSTTP; TestPoint_Pad_D1.5mm
TP66: MCfetOffTP; TestPoint_Pad_D1.5mm
TP67: CfetOffTP; TestPoint_Pad_D1.5mm
TP68: MDfetOffTP; TestPoint_Pad_D1.5mm
TP69: DfetOffTP; TestPoint_Pad_D1.5mm
TP70: DCHGTP; TestPoint_Pad_D1.5mm
TP71: DDSGTP; TestPoint_Pad_D1.5mm
TP72: RST_SHUTTP; TestPoint_Pad_D1.5mm
TsC1, TsC2, TsC3: 470 pF; 470pF_C0402
TsR1: 10k; 10k_62.5mW_R0402
TsRST1: Button; SW_Push_YZA-009
U1: BQ7695202; BQ7695202PFBR; PARTREV B
U2: STM32F205RETx; LQFP-64_10x10mm_P0.5mm
U4, U5, U6: LM66100DCKR
U7: LTC4359-DCB; DFN-6-1EP_3x2mm_P0.5mm_EP1.65x1.35mm
U9: AMS1117-3.3; SOT-223-3_TabPin2
USBC1, USBC2: 10 uF; 10uF_C0603
USBR1, USBR2: 5.1k; 5.1k_100mW_R0603
USBR3: 1.5k; 1.5k_100mW_R0603
X1: X322516MRB4SI; 18pF_Oscillator_CRYSTAL-SMD_4P; MPN X322516MRB4SI; LCSC Part C70562
X2: X49SM8MSD2SC; CRYSTAL-SMD_L11.5-W4.8-LS12.7; MPN X49SM8MSD2SC; LCSC Part C12674
XC1, XC3, XC4: 0.1uF; C_0402_1005Metric
XC2: 0.1uF; C_0603_1608Metric
XC5: 0.1 uF; C_0402_1005Metric
XCreg1: 0.47 uF; 0.47 uF_C1210
XCshun1: 0.1uF; C_0603_1608Metric
XRC1, XRC2, XRC3, XRC4: 1k; 1k_R1206
XRC5: 100; R_0402_1005Metric
XRreg1: 5; 5_1W_R2512
Xout1: 5.1k; 5.1k_100mW_R0603
Xshun1: 100; R_0402_1005Metric
better1: 1101A2CQEA-Switch

Connections:
ALERT: MCUR3.2, TP63.1 (1_1), U1.25 (ALERT), U2.25 (PC5)
BAT: BC1.1, BC2.1, BC3.1, BR1.2, TP10.1 (1_1), U1.47 (BAT)
BAT+: 3TFuse1.3, BD1.2 (A), J2.1, LEDR1.2, TP1.1 (1_1), XRC5.2, better1.2 (Comm), better1.3 (Off)
BREG: Q6.2 (B), RR2.2, TP44.1 (1_1), U1.37 (BREG)
CD: 3TFuse1.1, ChD2.2 (A), ChFet1.1 (S), ChFet1.2 (S), ChFet1.3 (S), ChR1.2, DFet2.5 (D), Dfet1.5 (D), PcC1.1, PcR1.1, PdC1.1, PdFet1.3 (S), PdR2.1, RD1.2 (A), TP26.1 (1_1)
CFETOFF: S1.3 (COM_1), TP67.1 (1_1), U1.29 (CFETOFF)
CHG: ChR2.1, U1.45 (CHG)
CP1: BC3.2, TP11.1 (1_1), U1.46 (CP1)
CPACK+: ChC1.1, ChD1.2 (A), J6.1, LEDR3.2, PCc2.2, PackR1.2, PcFet1.3 (S), PcR2.2, TP20.1 (1_1)
Cell1+/2-: C2-0.1, CC2-1.1, CR4.2, TP33.1 (1_1), U1.15 (VC1)
Cell1-: C1-0.1, CR5.2, TP16.1 (1_1), U1.16 (VC0)
Cell2+/3-: CC2-1.2, CC3-2.1, CR3.2, TP34.1 (1_1), U1.14 (VC2)
Cell3+/4-: CC3-2.2, CC4-3.1, CR2.2, TP35.1 (1_1), U1.1 (VC15), U1.2 (VC14), U1.3 (VC13), U1.4 (VC12), U1.5 (VC11), U1.6 (VC10), U1.7 (VC9), U1.8 (VC8), U1.9 (VC7), U1.10 (VC6), U1.11 (VC5), U1.12 (VC4), U1.13 (VC3)
Cell4+: CC4-3.2, CR1.2, TP36.1 (1_1), U1.48 (VC16)
DCHG: TP70.1 (1_1), U1.31 (DCHG), U2.24 (PC4)
DDSG: TP71.1 (1_1), U1.32 (DDSG), U2.11 (PC3)
DFETOFF: S1.6 (COM_2), TP69.1 (1_1), U1.30 (DFETOFF)
DPACK+: D17.2 (A), DC1.1, DC3.1, DFet3.5 (D), DFet4.5 (D), J4.1, LEDR2.2, NMOS1.1 (S), NMOS1.2 (S), NMOS1.3 (S), PdC2.2, PdR1.2, R46.2, TP21.1 (1_1), U7.1 (OUT)
DSG: DD2.1 (K), DR3.1, TP55.1 (1_1), U1.43 (DSG)
FUSE: FC1.1, FFet1.4 (G), FR1.2, FUSER2.2, TP27.1 (1_1), Xout1.2
HDQ: TH3.1, TP18.1 (1_1), TsC3.1, U1.28 (HDQ)
IDin: D1.1 (A1), DD1.2 (A), DD3.2 (A), DFet2.1 (S), DFet2.2 (S), DFet2.3 (S), DFet3.1 (S), DFet3.2 (S), DFet3.3 (S), DFet4.1 (S), DFet4.2 (S), DFet4.3 (S), DR1.2, DR4.2, Dfet1.1 (S), Dfet1.2 (S), Dfet1.3 (S), LDR1.2, TP50.1 (1_1), U7.3 (SRC), U7.4 (IN)
LD: LDR1.1, TP51.1 (1_1), U1.41 (LD)
MCUCFETOFF: S1.1 (NC_1), TP66.1 (1_1), U2.10 (PC2)
MCUDFETOFF: S1.4 (NC_2), TP68.1 (1_1), U2.9 (PC1)
unnamed: BD1.1 (K), BD2.1 (K), BR1.1
unnamed: BQ296115DSGR1.8 (OUT), TP43.1 (1_1), Xout1.1
unnamed: BQ296115DSGR1.7 (REG), TP42.1 (1_1), XRreg1.2
unnamed: BQ296115DSGR1.5 (V1), TP40.1 (1_1), XC1.2, XC2.2, XRC1.1
unnamed: BQ296115DSGR1.4 (V2), TP41.1 (1_1), XC2.1, XC3.2, XRC2.1
unnamed: BQ296115DSGR1.3 (V3), TP39.1 (1_1), XC3.1, XC4.2, XRC3.1
unnamed: BQ296115DSGR1.2 (V4), TP38.1 (1_1), XC4.1, XRC4.1
unnamed: BQ296115DSGR1.1 (VDD), TP37.1 (1_1), XC5.1, XRC5.1
unnamed: ChC1.2, ChC2.1
unnamed: ChD1.1 (K), ChFet1.5 (D)
unnamed: ChD2.1 (K), ChFet1.4 (G), ChR1.1, ChR2.2, TP22.1 (1_1)
unnamed: D1.2 (A2), D2.2 (A2)
unnamed: D2.1 (A1), DC3.2, DR5.2, TP58.1 (1_1), U7.6 (Vss), U7.7 (Pad)
unnamed: D15.1 (K), R47.1
unnamed: D17.1 (K), NMOS1.4 (G), R46.1, R47.2, TP53.1 (1_1)
unnamed: DC1.2, DC2.1
unnamed: DD1.1 (K), DR1.1, DR2.2, DR3.2, DRgate1.1, DRgate2.1, NMOS1.5 (D), TP54.1 (1_1)
unnamed: DD2.2 (A), DR2.1
unnamed: DD3.1 (K), DFetGate3.1, DFetGate4.1, DR4.1, TP57.1 (1_1), U7.2 (GATE)
unnamed: DFet2.4 (G), DRgate2.2
unnamed: DFet3.4 (G), DFetGate3.2
unnamed: DFet4.4 (G), DFetGate4.2
unnamed: DRgate1.2, Dfet1.4 (G)
unnamed: 3TFuse1.2, FFet1.5 (D)
unnamed: J7.A5 (CC1), USBR1.1
unnamed: J7.B5 (CC2), USBR2.2
unnamed: LED1.2 (A), LEDR1.1
unnamed: LED2.2 (A), LEDR2.1
unnamed: LED3.2 (A), LEDR3.1
unnamed: LED5.2 (A), LEDR5.1
unnamed: PCc2.1, PcC1.2
unnamed: PcFet1.1 (D), PcR1.2
unnamed: PcFet1.2 (G), PcR2.1, PcR3.2, TP48.1 (1_1)
unnamed: PdC1.2, PdC2.1
unnamed: PdFet1.1 (D), PdR1.1
unnamed: PdFet1.2 (G), PdR2.2, PdR3.1, TP49.1 (1_1)
unnamed: Q6.1 (C), RC1.1, RR1.1, TP14.1 (1_1)
unnamed: RD1.1 (K), RD2.1 (K), RR1.2, TP13.1 (1_1)
unnamed: Rshunt1.1, Rshunt2.2, S5.3
unnamed: Rshunt1.2, S6.3
unnamed: Rshunt2.1, Rshunt3.2, S4.3
unnamed: Rshunt3.1, Rshunt4.2, S3.3
unnamed: TsR1.1, TsRST1.2 (B)
unnamed: FUSER2.1, U1.38 (FUSE)
unnamed: BMSC1.2, U1.24 (REG18)
unnamed: BOOTSW1.1, MCUR2.1, TP64.1 (1_1), U2.60 (BOOT0)
unnamed: MCUC19.1, MCUR1.2, NRSTSW2.2, TP65.1 (1_1), U2.7 (NRST)
unnamed: MCUR4.1, U2.28 (PB2)
unnamed: FB1.1, MCUR5.2, MCUTVS1.2, U2.58 (PB6)
unnamed: FB2.1, MCUR6.2, MCUTVS2.2, U2.59 (PB7)
unnamed: MCUC20.1, TP61.1 (1_1), U2.31 (VCAP_1)
unnamed: MCUC21.1, TP62.1 (1_1), U2.47 (VCAP_2)
unnamed: XCreg1.1, XRreg1.1
unnamed: XCshun1.1, Xshun1.2
OSC_OUT: OSCC2.1, R1.1, U2.6 (PH1), X1.3 (OSC2)
PACK: PackR1.1, TP52.1 (1_1), U1.42 (PACK)
PACK-: ChC2.2, DC2.2, FRShunt1.2, J4.2 (N), J6.2 (N), LED2.1 (K), LED3.1 (K), SRinP1.2
PCHG: PcR3.1, U1.40 (PCHG)
PDSG: PdR3.2, U1.39 (PDSG)
PWR+: BD2.2 (A), J3.1, LEDR5.2, RD2.2 (A), Rshunt4.1, S2.3, TP9.1 (1_1), better1.1 (On)
REG1: C72.1, RC3.2, TP46.1 (1_1), U1.35 (REG1), U6.1 (VIN)
REG2: RC4.2, U1.34 (REG2)
REGIN: Q6.3 (E), RC2.1, U1.36 (REGIN)
RST_SHUT: TP72.1 (1_1), U1.33 (RST_SHUT), U2.8 (PC0)
SCL: FB1.2, TP25.1 (1_1), U1.26 (SCL)
SDA: FB2.2, TP24.1 (1_1), U1.27 (SDA)
SRN: C4.1, SC1.1, SC3.1, SRinN1.1, TP6.1 (1_1), U1.18 (SRP)
SRP: C4.2, SC2.1, SC3.2, SRinP1.1, TP8.1 (1_1), U1.20 (SRN)
SWCLK: J5.4 (SWCLK), U2.49 (PA14)
SWDIO: J5.3 (SWDIO), U2.46 (PA13)
TS1: TH1.1, TP12.1 (1_1), TsC1.1, U1.21 (TS1)
TS2: TP17.1 (1_1), TsRST1.1 (A), U1.22 (TS2)
TS3: TH2.1, TP15.1 (1_1), TsC2.1, U1.23 (TS3)
USART1_RX: J1.2, MCUTVS4.2, TP23.1 (1_1), U2.43 (PA10)
USART1_TX: J1.1, MCUTVS3.2, TP5.1 (1_1), U2.42 (PA9)
USB_C_VBUS: J7.A4 (VBUS), J7.A9 (VBUS), J7.B4 (VBUS), J7.B9 (VBUS), U9.3 (VI), USBC1.1
USB_D+: J7.A6 (D+), J7.B6 (D+), U2.45 (PA12), USBR3.2
USB_D-: J7.A7 (D-), J7.B7 (D-), U2.44 (PA11)
V1: CR4.1, Cellin1.2, S5.1, S5.2, TP29.1 (1_1), XRC1.2
V2: CR3.1, Cellin1.3, S4.1, S4.2, TP30.1 (1_1), XRC2.2
V3: CR2.1, Cellin1.4, S3.1, S3.2, TP31.1 (1_1), XRC3.2
V4: CR1.1, Cellin1.5, S2.1, S2.2, TP32.1 (1_1), XRC4.2, Xshun1.1
VDD: BOOTSW1.2, MCUC11.1, MCUC12.1, MCUC13.1, MCUC14.1, MCUC15.1, MCUC16.1, MCUC17.1, MCUC18.1, MCUR1.1, MCUR3.1, MCUR5.1, MCUR6.1, S1.2 (NO_1), S1.5 (NO_2), U2.1 (VBAT), U2.13 (VDDA), U2.19 (VDD), U2.32 (VDD), U2.48 (VDD), U2.64 (VDD), U4.3 (*CE), U4.6 (VOUT), U5.3 (*CE), U5.6 (VOUT), U6.3 (*CE), U6.6 (VOUT), USBR3.1
V_REGUSB: C71.1, TP60.1 (1_1), U5.1 (VIN), U9.2 (VO), USBC2.1
V_SWD: C70.1, J5.2 (VDD), TP59.1 (1_1), U4.1 (VIN)

Notes on the sheet:
Ideal Diodes (Power Input Mux)
Power supply to VDD pins (1.8 - 3.6 V) The 4.7 µF ceramic capacitor must be connected to one of the VDD pins
High current ideal diode
Pre Charge/Discharge circuit
When the CE pin voltage is higher than the VIN by 80 mV, the device is disabled and the MOSFET is off. When the CE pin voltage is lower than VIN by 250 mV, the MOSFET is on. Comes with reverse polarity protection (RPP).
44 should also be NC -> not present on this
S - (Shunt) Kelvin setup for current measurement
B - Battery and Charge pump circuit
Reg circuit
X - External Cell protector
UART Setup
(Active low)
Power supply to VDDA pin
Battery in
MCU Physical E-stop
PBat - Voltage Divider
gmcrit = 4*(ESR + Rext)*(2*pi*F)^2 * (C0 + CL)^2 = 4*1070*(2*pi*8 MHz)^2 * (7 pF + 20 pF)^2 = 7.85 mA/V
CL = (CLcrystal - Cstray)*2 = (18 - 10)*2 = 16 pF gmcrit = 4*ESR*(2*pi*F)^2 *(C0 + CL)^2 = 4*50*(2*pi*16 MHz)^2 * (3 pF + 16 pF)^2 = 0.729 mA/V gain margin = gm/gmcrit = 5 mA/V / 0.729 mA/V = 6.86 The gain margin is sufficient to start the oscillation and the gainmargin > 5 condition is met.
MCU corner
Discharge circuit
USB Connection
Connect to board's main power rail VDD provides a reference voltage so the debugger knows if board is powered on and what logic voltage to use
Pre Dsg/CHG and general attachment PD and PC
PSeudoCell - Voltage Divider
Crystal Oscillator
T - TS1, TS2, TS3 circuit
connection protection
BOOT1
Recommended Wideband SMT ferrites (742792693)
External 12V supply in
CL = (CLcrystal - Cstray)*2 = (20 - 10)*2 = 20 pF gmcrit = 4*ESR*(2*pi*F)^2 *(C0 + CL)^2 = 4*70*(2*pi*8 MHz)^2 * (7 pF + 20 pF)^2 = 0.516 mA/V gain margin = gm/gmcrit = 5 mA/V / 0.516 mA/V = 9.69 The gain margin is sufficient to start the oscillation and the gainmargin > 5 condition is met. Rext = 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
Serial Wire Debug
Charge circuit
Indicator LEDs - NEED to switch LEDs to correct model
It is recommended to power VDD and VDDA from the same source. VREF+ is internally connected to VDDA and VREF- is internally connected to VSSA.

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
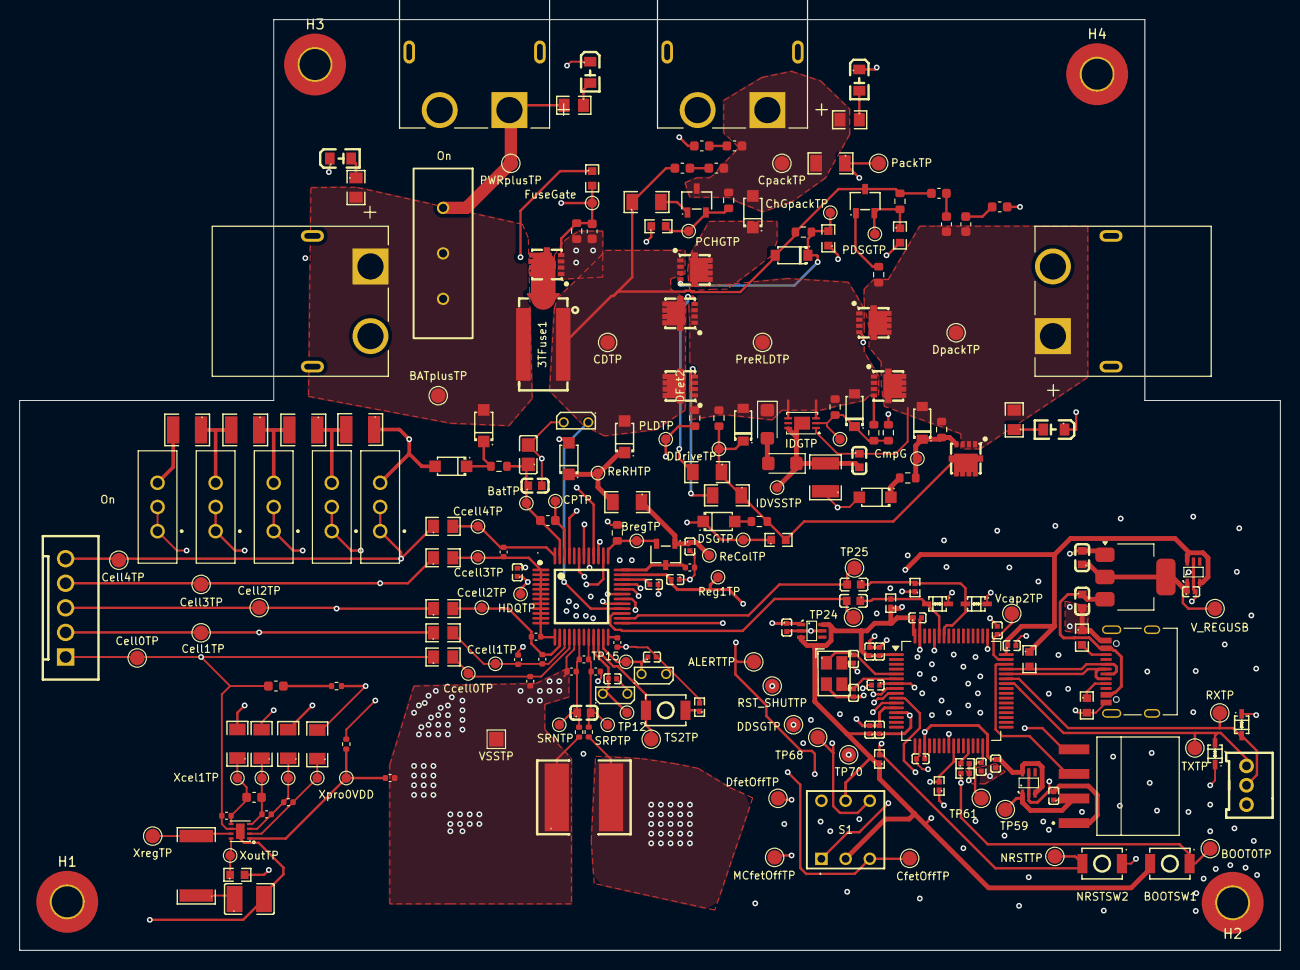
[picture p10: board Aqua BMS Monitor(MAIN).kicad_pcb from above]

Board: 4 copper layers, 130.2 x 96.2 mm, 248 parts (0 on the bottom side), 112 nets.
