aQuatonomous/Aqua-BMS-Monitor/(commit log)

2026-03-31 Initial setup and some organization
    [Aqua BMS Monitor.kicad_sch]
2026-03-31 Updates
    Cell monitor and shunt resistor complete
    [Aqua BMS Monitor.kicad_sch]
2026-03-31 Updates
    Thermosister and BAT/CP1 circuit updated
    [Aqua BMS Monitor.kicad_sch]
2026-03-31 Main circuits done
    All circuits I (kinda) understand are organised
    [Aqua BMS Monitor.kicad_sch]
2026-04-01 Commits before fork
    [Aqua BMS Monitor.kicad_sch]
2026-05-12 Big Updates
    [Aqua BMS Monitor.kicad_sch]
2026-05-24 V1 Parellel paths
    [Aqua BMS Monitor.kicad_sch]
2026-05-26 Update Aqua BMS Monitor.kicad_sch
    [Aqua BMS Monitor.kicad_sch]
2026-05-31 Discharge/Charge Circuit v1 done
    Up for review and explanation
    [Aqua BMS Monitor.kicad_sch]
2026-06-04 STM32 Connections
    First version, definitely needs some changes
    [aQua BMS MCU.kicad_sch]
2026-06-04 aQua BMS MCU Updated June 4
    Fixed? VCAP1 and VCAP2 connections, added BOOT0 pin connection
    [aQua BMS MCU.kicad_sch]
2026-06-10 Aqua BMS Monitor and MCU
    Added STM32 schematic to main sheet, fixed some pins on MCU
    [Aqua BMS Monitor and MCU.kicad_sch]
2026-06-15 Updated June 15
    Changes to 2nd-level battery overvoltage protection circuit
    [Aqua BMS Monitor (2).kicad_sch]
2026-06-17 Updated June 17
    [Aqua BMS Monitor (2).kicad_sch]
2026-06-19 Updated June 19
    [Aqua BMS Monitor (2).kicad_sch]
2026-07-02 Added SDA and SCL filter and surge protection
    [Aqua BMS Monitor July 1.kicad_sch]
2026-07-07 Updated STM32 connections
    [Aqua BMS Monitor(MAIN).kicad_sch]
2026-07-10 Protecting Commits on This branch
    [Aqua BMS Monitor(MAIN).kicad_sch]
2026-07-10 Update Aqua BMS Monitor(MAIN).kicad_sch
    [Aqua BMS Monitor(MAIN).kicad_sch]
2026-07-14 Removed VR, fixed UART setup
    [Aqua BMS Monitor(MAIN).kicad_sch]
2026-07-19 Create clamp spice simulation
2026-07-19 Added Ideal diode files
2026-07-21 Add files via upload
    Changed TVS diodes
    [Aqua BMS Monitor(MAIN).kicad_sch]
2026-07-23 Assigned some footprints
    [Aqua BMS Monitor(MAIN).kicad_sch]
2026-07-23 Several changes
    - Renamed components in discharge circuit
    - Removed blocking fets
    - Added physical E-stop switch mechanism
    - Added ideal diode and test points
    - Renamed components for MCU
    - Added final test points
    [Aqua BMS Monitor(MAIN).kicad_pcb, Aqua BMS Monitor(MAIN).kicad_sch]
2026-07-23 Critical Change to project file so that PCB files reads project
2026-07-23 Library changes
    [Aqua BMS Monitor(MAIN).kicad_sch]
2026-07-23 nothing much
    [Aqua BMS Monitor(MAIN).kicad_sch]
2026-07-23 Maybe a mess, maybe a good thing
    [Aqua BMS Monitor(MAIN).kicad_sch, BQ76952PFBR.step]
2026-07-23 Final changes, pushing merging with main
    [Aqua BMS Monitor(MAIN).kicad_sch]
2026-07-23 4P pin header, ideal diode TVS diodes
2026-07-23 Changed USB setup, assigned footprints
    [Aqua BMS Monitor(MAIN).kicad_sch]
2026-07-23 New footprints
2026-07-24 Please work
    [Aqua BMS Monitor(MAIN).kicad_sch]
2026-07-24 Added Male XT60s
    [Aqua BMS Monitor(MAIN).kicad_sch]
2026-07-24 Added three-terminal fuse
2026-07-24 Added connector footprints
2026-07-24 Cleaned up netlist and schematic
    [Aqua BMS Monitor(MAIN).kicad_pcb, Aqua BMS Monitor(MAIN).kicad_sch]
2026-07-25 Updates
    - PCB organisation
    - Some reroutes on schematic
    - Adding new components for fake bat/cells
    [Aqua BMS Monitor(MAIN).kicad_pcb, Aqua BMS Monitor(MAIN).kicad_sch]
2026-07-25 Update Aqua BMS Monitor(MAIN).kicad_pcb
    [Aqua BMS Monitor(MAIN).kicad_pcb]
2026-07-25 PCB and schem arrangement/changes
    [Aqua BMS Monitor(MAIN).kicad_pcb, Aqua BMS Monitor(MAIN).kicad_sch]
2026-07-25 Renamed a folder to fix routing issue in library
    [Aqua BMS Monitor(MAIN).kicad_pcb, Aqua BMS Monitor(MAIN).kicad_sch, XT60PW-M.step]
2026-07-26 more changes
    [Aqua BMS Monitor(MAIN).kicad_pcb, Aqua BMS Monitor(MAIN).kicad_sch]
2026-07-26 More changes - lots of uncertainty
    [Aqua BMS Monitor(MAIN).kicad_pcb, Aqua BMS Monitor(MAIN).kicad_sch]
2026-07-28 Right-angle USB C footprint
2026-07-28 Added right-angle USB-C footprint
2026-07-28 Added 0402 16 pF capacitor
2026-07-28 Very slight MCU organization
    [Aqua BMS Monitor(MAIN).kicad_pcb, Aqua BMS Monitor(MAIN).kicad_sch]
2026-07-30 Major additions and implementation to the cell balancing and reading network
    [Aqua BMS Monitor(MAIN).kicad_pcb, Aqua BMS Monitor(MAIN).kicad_sch]
2026-07-30 Reuploading all footprints
2026-07-31 cooking in the dark
    - finished cell monitoring/balancing setup
    - Added ground planes
    - Created bat and CP1 circuit
    [Aqua BMS Monitor(MAIN).kicad_pcb, Aqua BMS Monitor(MAIN).kicad_sch]
2026-08-03 MCU is looking slightly put together xx
    [Aqua BMS Monitor(MAIN).kicad_pcb, Aqua BMS Monitor(MAIN).kicad_sch]
2026-08-04 Grinding on the power line :)
    [Aqua BMS Monitor(MAIN).kicad_pcb, Aqua BMS Monitor(MAIN).kicad_sch, EG1218.step]
2026-08-05 All done routing the main power lines
    [Aqua BMS Monitor(MAIN).kicad_pcb, Aqua BMS Monitor(MAIN).kicad_sch]
2026-08-05 Just a freaking mess
    [Aqua BMS Monitor(MAIN).kicad_pcb, Aqua BMS Monitor(MAIN).kicad_sch]
2026-08-05 We getting there
    [Aqua BMS Monitor(MAIN).kicad_pcb]
2026-08-06 Just disturbing to look at tbh
    [Aqua BMS Monitor(MAIN).kicad_pcb, Aqua BMS Monitor(MAIN).kicad_sch]
2026-08-07 Sized down 470 pF capacitor
2026-08-08 minor changes
    [Aqua BMS Monitor(MAIN).kicad_pcb, Aqua BMS Monitor(MAIN).kicad_sch]
2026-08-10 Small fixes
    [Aqua BMS Monitor(MAIN).kicad_pcb]
2026-08-11 Not sure
    [Aqua BMS Monitor(MAIN).kicad_pcb, Aqua BMS Monitor(MAIN).kicad_sch]
2026-08-12 Final for now
    [Aqua BMS Monitor(MAIN).kicad_pcb]
2026-08-13 Couple fixes
    - Fixed ground plane
    - changed thermistor placement
    - Attached floating components
    [Aqua BMS Monitor(MAIN).kicad_pcb, Aqua BMS Monitor(MAIN).kicad_sch]
2026-08-13 Bill of Materials (BOM)
    [bom.csv.xlsx]
2026-08-14 coupla changes
    [Aqua BMS Monitor(MAIN).kicad_pcb]
2026-08-14 Added gaping holes
    [Aqua BMS Monitor(MAIN).kicad_pcb, Aqua BMS Monitor(MAIN).kicad_sch]
2026-08-14 Changes to mounting points and gnd path
    [Aqua BMS Monitor(MAIN).kicad_pcb, Aqua BMS Monitor(MAIN).kicad_sch]
2026-08-16 Cleaned up comments and USB lines
    [Aqua BMS Monitor(MAIN).kicad_pcb, Aqua BMS Monitor(MAIN).kicad_sch]
2026-08-25 Modifying oscillator
    [Aqua BMS Monitor(MAIN).kicad_sch]
2026-09-01 Reviewed and edited the bom
    [bom.csv.xlsx]
2026-09-01 Slightly rushed bom review
    [bom.csv (1).xlsx]
2026-09-01 Rushed bom review oops
    [bom.csv.xlsx]
2026-09-03 Put files together in jlc-files folder
    [Aqua BMS Monitor(MAIN)-B_Cu.gbl, Aqua BMS Monitor(MAIN)-B_Mask.gbs, Aqua BMS Monitor(MAIN)-B_Paste.gbp, Aqua BMS Monitor(MAIN)-B_Silkscreen.gbo, Aqua BMS Monitor(MAIN)-Edge_Cuts.gm1, Aqua BMS Monitor(MAIN)-F_Cu.gtl, Aqua BMS Monitor(MAIN)-F_Mask.gts, Aqua BMS Monitor(MAIN)-F_Paste.gtp]
2026-09-03 fixed floating trace
    [Aqua BMS Monitor(MAIN)-B_Cu.gbl, Aqua BMS Monitor(MAIN)-B_Mask.gbs, Aqua BMS Monitor(MAIN)-B_Paste.gbp, Aqua BMS Monitor(MAIN)-B_Silkscreen.gbo, Aqua BMS Monitor(MAIN)-Edge_Cuts.gm1, Aqua BMS Monitor(MAIN)-F_Cu.gtl, Aqua BMS Monitor(MAIN)-F_Mask.gts, Aqua BMS Monitor(MAIN)-F_Paste.gtp]
2026-09-09 Fixed git ignore, welcome CSVs!
    [Aqua_BMS_Monitor_Cleaned.csv, bom.csv]
2026-09-09 Removed thermistor rows
    [bom.csv]
2026-09-09 Changed ideal diode and removed 4 pin
    [bom.csv]
2026-09-09 removed more headers
    [bom.csv]
2026-09-09 moved gerbers and added zip
    [Aqua BMS Monitor(MAIN)-B_Cu.gbl, Aqua BMS Monitor(MAIN)-B_Mask.gbs, Aqua BMS Monitor(MAIN)-B_Paste.gbp, Aqua BMS Monitor(MAIN)-B_Silkscreen.gbo, Aqua BMS Monitor(MAIN)-Edge_Cuts.gm1, Aqua BMS Monitor(MAIN)-F_Cu.gtl, Aqua BMS Monitor(MAIN)-F_Mask.gts, Aqua BMS Monitor(MAIN)-F_Paste.gtp]
